Radar-Uniwa/5-6GHz-FMCW-Radar/Hardware/UFL footprint/CONMHF1-SMD-T.step

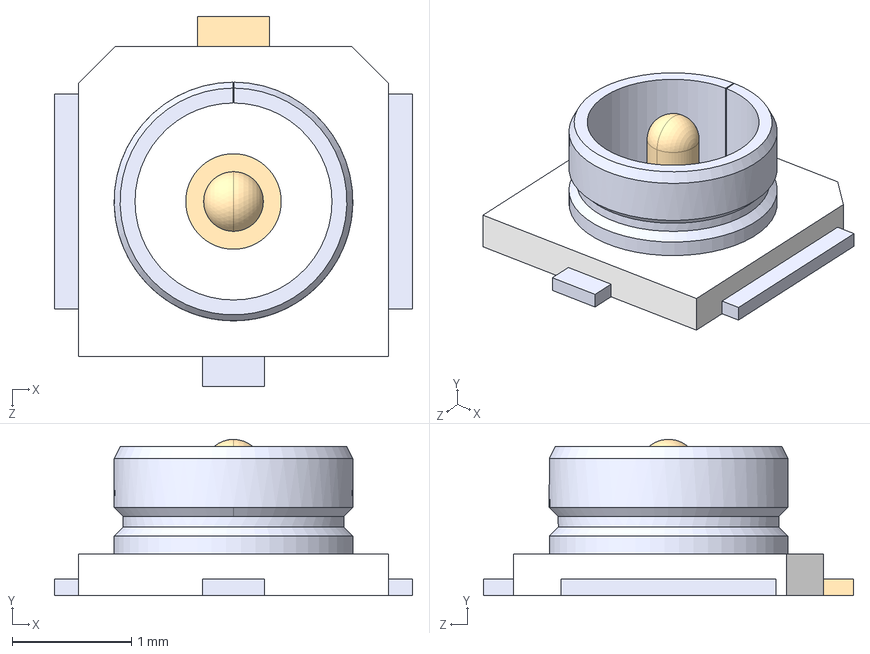
[picture p1: CAD file, 2026-07-16]
Hardware/UFL footprint/CONMHF1-SMD-T.step
3.00 x 1.31 x 3.10 mm
