Radar-Uniwa/5-6GHz-FMCW-Radar/(list of files, drawings)

Other design files:
CST/Coupler Simulation/Model/3D/Model.dsn
CST/Coupler Simulation/Model/DS/Model.dsn
