Radar-Uniwa/5-6GHz-FMCW-Radar/Hardware/adc.kicad_sch

## KiCad design Hardware/adc.kicad_sch (2026-07-16)

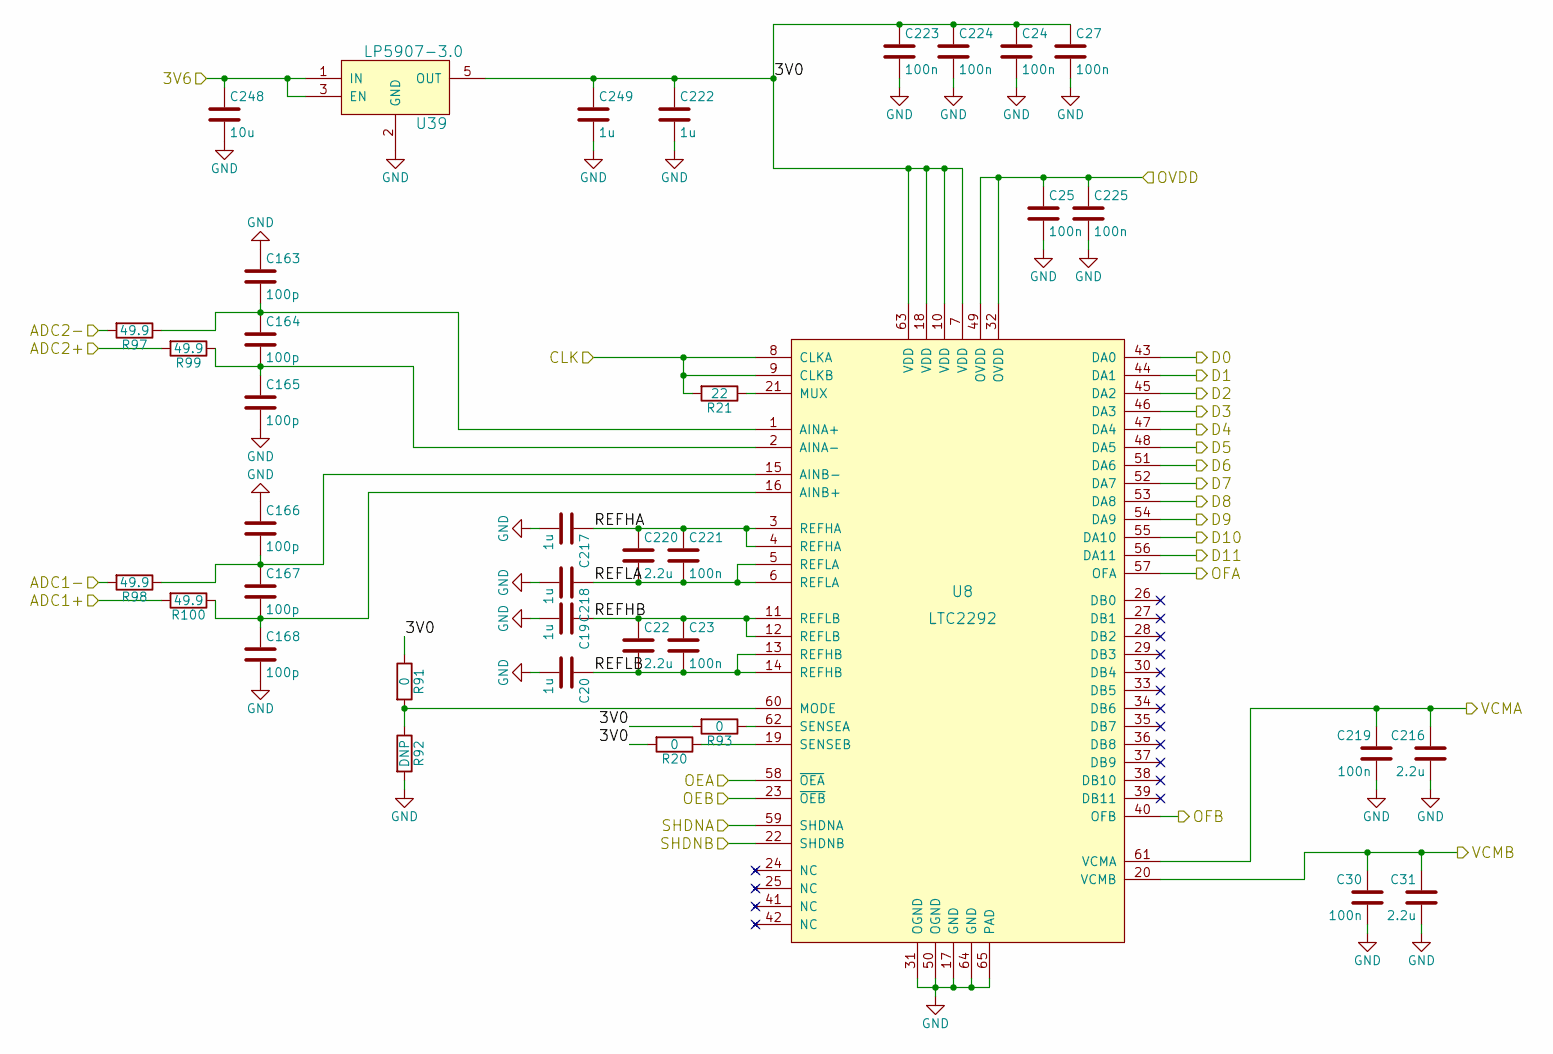
[picture p2: schematic adc.kicad_sch]

Parts:
C19, C20, C217, C218, C222, C249: 1u; C_0603b
C22, C31, C216, C220: 2.2u; C_0603b
C23, C24, C25, C27, C30, C219, C221, C223, C224, C225: 100n; C_0402b
C163, C164, C165, C166, C167, C168: 100p; C_0402b
C248: 10u; C_0805b
R20, R91, R93: 0; R_0402b
R21: 22; R_0402b
R92: DNP; R_0402b
R97, R98, R99, R100: 49.9; R_0402b
U8: LTC2292; QFN-64-1EP_9x9mm_Pitch0.5mm
U39: LP5907-3.0; SOT-23-5

Connections:
3V0: C24.1, C27.1, C222.1, C223.1, C224.1, C249.1, R20.2, R91.1, R93.2, U8.7 (VDD), U8.10 (VDD), U8.18 (VDD), U8.63 (VDD), U39.5 (OUT)
3V6: C248.1, U39.1 (IN), U39.3 (EN)
ADC1+: R100.2
ADC1-: R98.2
ADC2+: R99.2
ADC2-: R97.2
CLK: R21.2, U8.8 (CLKA), U8.9 (CLKB)
D0: U8.43 (DA0)
D1: U8.44 (DA1)
D2: U8.45 (DA2)
D3: U8.46 (DA3)
D4: U8.47 (DA4)
D5: U8.48 (DA5)
D6: U8.51 (DA6)
D7: U8.52 (DA7)
D8: U8.53 (DA8)
D9: U8.54 (DA9)
D10: U8.55 (DA10)
D11: U8.56 (DA11)
GND: C19.2, C20.2, C24.2, C25.2, C27.2, C30.2, C31.2, C163.1, C165.2, C166.1, C168.2, C216.2, C217.2, C218.2, C219.2, C222.2, C223.2, C224.2, C225.2, C248.2, C249.2, R92.2, U8.17 (GND), U8.31 (OGND), U8.50 (OGND), U8.64 (GND), U8.65 (PAD), U39.2 (GND)
unnamed: C163.2, C164.1, R97.1, U8.1 (AINA+)
unnamed: C164.2, C165.1, R99.1, U8.2 (AINA-)
unnamed: C166.2, C167.1, R98.1, U8.15 (AINB-)
unnamed: C167.2, C168.1, R100.1, U8.16 (AINB+)
unnamed: R20.1, U8.19 (SENSEB)
unnamed: R21.1, U8.21 (MUX)
unnamed: R91.2, R92.1, U8.60 (MODE)
unnamed: R93.1, U8.62 (SENSEA)
OEA: U8.58 (~OEA)
OEB: U8.23 (~OEB)
OFA: U8.57 (OFA)
OFB: U8.40 (OFB)
OVDD: C25.1, C225.1, U8.32 (OVDD), U8.49 (OVDD)
REFHA: C217.1, C220.1, C221.1, U8.3 (REFHA), U8.4 (REFHA)
REFHB: C19.1, C22.1, C23.1, U8.11 (REFLB), U8.12 (REFLB)
REFLA: C218.1, C220.2, C221.2, U8.5 (REFLA), U8.6 (REFLA)
REFLB: C20.1, C22.2, C23.2, U8.13 (REFHB), U8.14 (REFHB)
SHDNA: U8.59 (SHDNA)
SHDNB: U8.22 (SHDNB)
VCMA: C216.1, C219.1, U8.61 (VCMA)
VCMB: C30.1, C31.1, U8.20 (VCMB)
