Radar-Uniwa/5-6GHz-FMCW-Radar/Hardware/fmcw3.kicad_sch

## KiCad design Hardware/fmcw3.kicad_sch (2026-07-16)

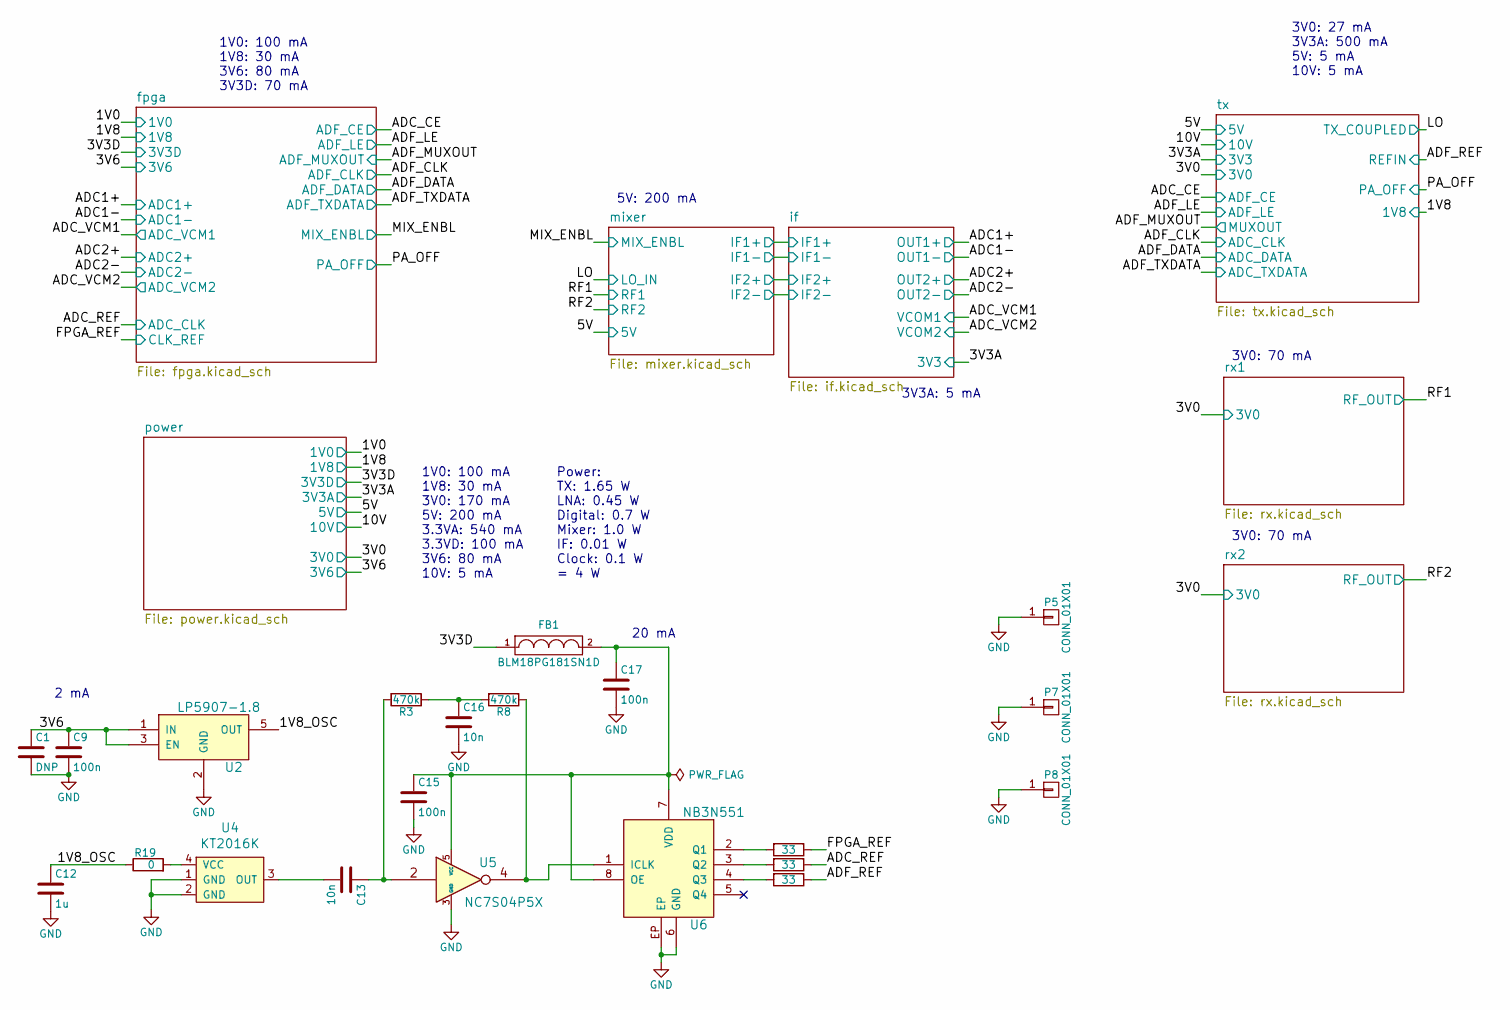
[picture p3: schematic fmcw3.kicad_sch]

Parts:
C1: DNP; C_0805b
C9, C15, C17: 100n; C_0402b
C12: 1u; C_0603b
C13, C16: 10n; C_0402b
FB1: BLM18PG181SN1D; C_0603b
P5, P7, P8: CONN_01X01; MountingHole_3.2mm_M3_Pad_Via_mod
R3, R8: 470k; R_0402b
R13, R15, R16: 33; R_0402b
R19: 0; R_0402b
U2: LP5907-1.8; SOT-23-5
U4: KT2016K
U5: NC7S04P5X; SOT-353_SC-70-5
U6: NB3N551; DFN-8

Connections:
1V8_OSC: C12.1, R19.1, U2.5 (OUT)
3V3D: FB1.1
3V6: C1.1, C9.1, U2.1 (IN), U2.3 (EN)
ADC_REF: R15.1
ADF_REF: R16.1
FPGA_REF: R13.1
GND: C1.2, C9.2, C12.2, C15.2, C16.2, C17.2, P5.1, P7.1, P8.1, U2.2 (GND), U4.1 (GND), U4.2 (GND), U5.3 (GND), U6.6 (GND), U6.EP
unnamed: C13.1, R3.2, U5.2
unnamed: C13.2, U4.3 (OUT)
unnamed: C15.1, C17.1, FB1.2, U5.5 (VCC), U6.7 (VDD), U6.8 (OE)
unnamed: C16.1, R3.1, R8.2
unnamed: R8.1, U5.4, U6.1 (ICLK)
unnamed: R13.2, U6.2 (Q1)
unnamed: R15.2, U6.3 (Q2)
unnamed: R16.2, U6.4 (Q3)
unnamed: R19.2, U4.4 (VCC)

Notes on the sheet:
5V: 200 mA
1V0: 100 mA 1V8: 30 mA 3V6: 80 mA 3V3D: 70 mA
3V0: 27 mA 3V3A: 500 mA 5V: 5 mA 10V: 5 mA
Power: TX: 1.65 W LNA: 0.45 W Digital: 0.7 W Mixer: 1.0 W IF: 0.01 W Clock: 0.1 W = 4 W
1V0: 100 mA 1V8: 30 mA 3V0: 170 mA 5V: 200 mA 3.3VA: 540 mA 3.3VD: 100 mA 3V6: 80 mA 10V: 5 mA
20 mA
2 mA
3V0: 70 mA
3V3A: 5 mA
