Radar-Uniwa/5-6GHz-FMCW-Radar/Hardware/fpga.kicad_sch

## KiCad design Hardware/fpga.kicad_sch (2026-07-16)

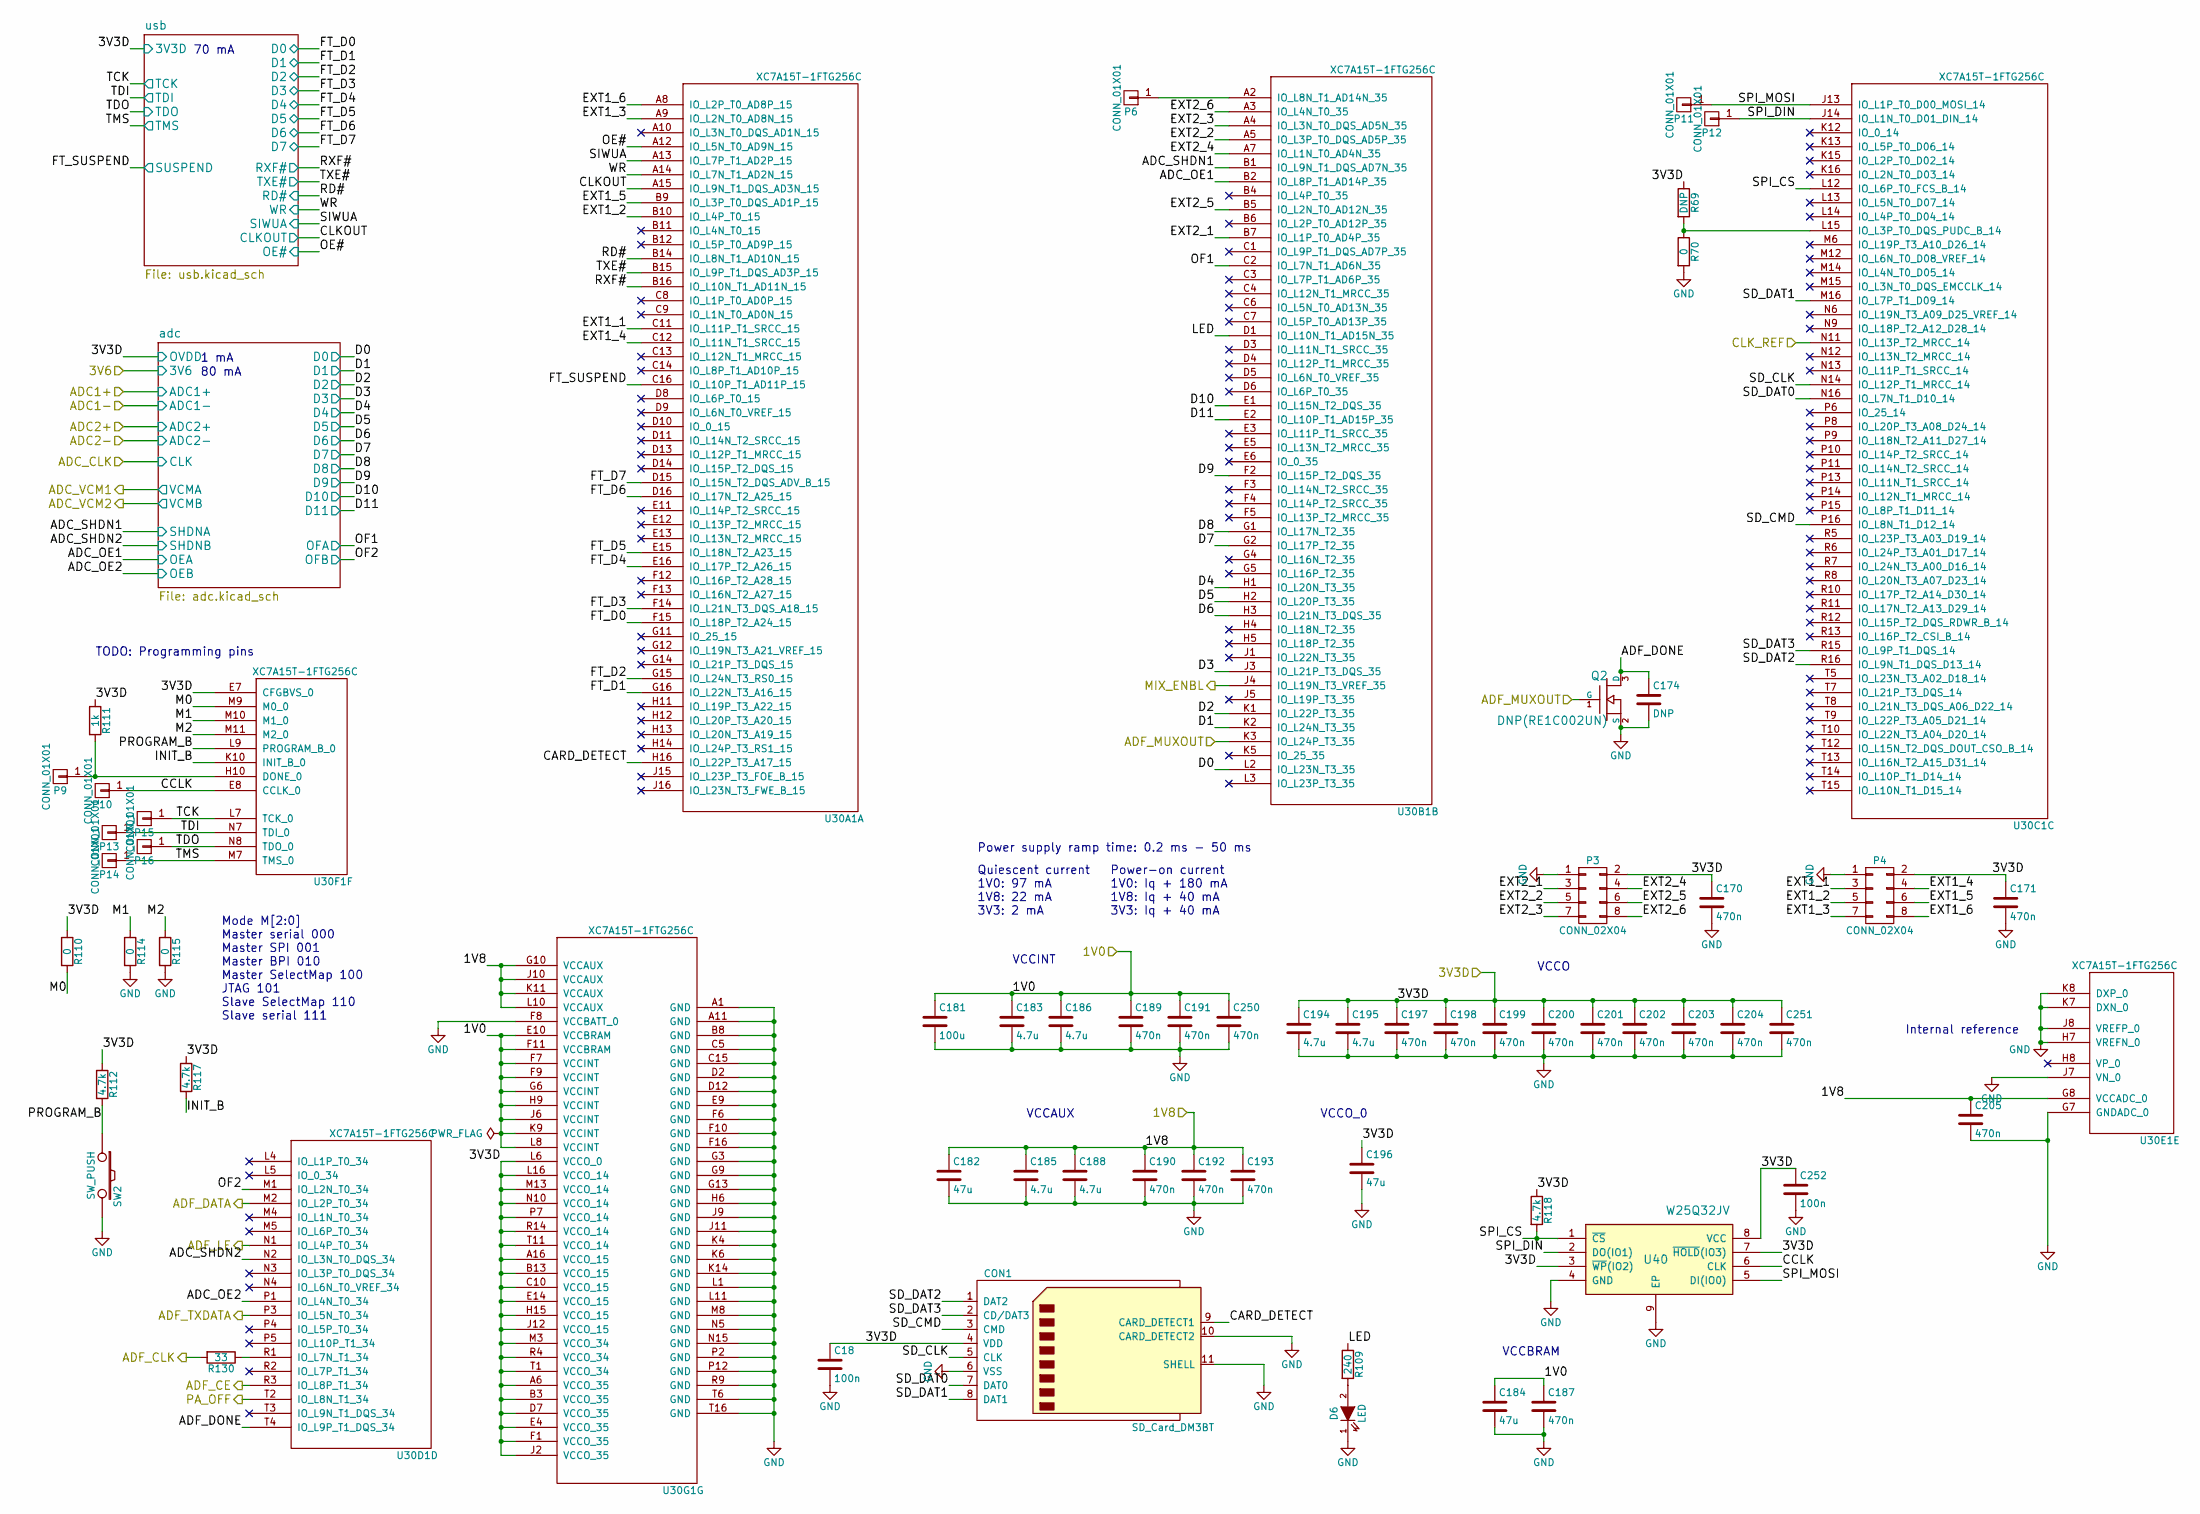
[picture p4: schematic fpga.kicad_sch]

Parts:
C18, C252: 100n; C_0402b
C170, C171, C187, C189, C190, C191, C192, C193, C197, C198, C199, C200, C201, C202, C203, C204, C205, C250, C251: 470n; C_0402b
C174: DNP; C_0402b
C181: 100u; C_1210
C182, C184, C196: 47u; C_1206
C183, C185, C186, C188, C194, C195: 4.7u; C_0805b
CON1: SD_Card_DM3BT; DM3BT-DSF-PEJS
D6: LED; LED_0603
P3, P4: CONN_02X04; Pin_Header_Straight_2x04_Pitch2.54mm_SMD
P6, P9, P10, P11, P12, P13, P14, P15, P16: CONN_01X01; TP_1.00
Q2: DNP(RE1C002UN); SOT-416
R69: DNP; R_0402b
R70, R110, R114, R115: 0; R_0402b
R109: 240; R_0402b
R111: 1k; R_0402b
R112, R117, R118: 4.7k; R_0402b
R130: 33; R_0402b
SW2: SW_PUSH; EVP-AWBA2A
U30A1, U30B1, U30C1, U30D1, U30E1, U30F1, U30G1: XC7A15T-1FTG256C; FTG256
U40: W25Q32JV; DFN-S-8-1EP_6x5mm_Pitch1.27mm

Connections:
1V0: C181.1, C183.1, C184.1, C186.1, C187.1, C189.1, C191.1, C250.1, U30G1.E10 (VCCBRAM), U30G1.F7 (VCCINT), U30G1.F9 (VCCINT), U30G1.F11 (VCCBRAM), U30G1.G6 (VCCINT), U30G1.H9 (VCCINT), U30G1.J6 (VCCINT), U30G1.K9 (VCCINT), U30G1.L8 (VCCINT)
1V8: C182.1, C185.1, C188.1, C190.1, C192.1, C193.1, C205.1, U30E1.G8 (VCCADC_0), U30G1.G10 (VCCAUX), U30G1.J10 (VCCAUX), U30G1.K11 (VCCAUX), U30G1.L10 (VCCAUX)
3V3D: C18.1, C170.1, C171.1, C194.1, C195.1, C196.1, C197.1, C198.1, C199.1, C200.1, C201.1, C202.1, C203.1, C204.1, C251.1, C252.1, CON1.4 (VDD), P3.2, P4.2, R69.1, R110.1, R111.1, R112.1, R117.1, R118.1, U30F1.E7 (CFGBVS_0), U30G1.A6 (VCCO_35), U30G1.A16 (VCCO_15), U30G1.B3 (VCCO_35), U30G1.B13 (VCCO_15), U30G1.C10 (VCCO_15), U30G1.D7 (VCCO_35), U30G1.E4 (VCCO_35), U30G1.E14 (VCCO_15), U30G1.F1 (VCCO_35), U30G1.H15 (VCCO_15), U30G1.J2 (VCCO_35), U30G1.J12 (VCCO_15), U30G1.L6 (VCCO_0), U30G1.L16 (VCCO_14), U30G1.M3 (VCCO_34), U30G1.M13 (VCCO_14), U30G1.N10 (VCCO_14), U30G1.P7 (VCCO_14), U30G1.R4 (VCCO_34), U30G1.R14 (VCCO_14), U30G1.T1 (VCCO_34), U30G1.T11 (VCCO_14), U40.3 (~WP(IO2)), U40.7 (~HOLD(IO3)), U40.8 (VCC)
ADC_OE1: U30B1.B2 (IO_L8P_T1_AD14P_35)
ADC_OE2: U30D1.P1 (IO_L4N_T0_34)
ADC_SHDN1: U30B1.B1 (IO_L9N_T1_DQS_AD7N_35)
ADC_SHDN2: U30D1.N2 (IO_L3N_T0_DQS_34)
ADF_CE: U30D1.R3 (IO_L8P_T1_34)
ADF_CLK: R130.2
ADF_DATA: U30D1.M2 (IO_L2P_T0_34)
ADF_DONE: C174.1, Q2.3 (D), U30D1.T4 (IO_L9P_T1_DQS_34)
ADF_LE: U30D1.N1 (IO_L4P_T0_34)
ADF_MUXOUT: Q2.1 (G), U30B1.K3 (IO_L24P_T3_35)
ADF_TXDATA: U30D1.P3 (IO_L5N_T0_34)
CARD_DETECT: CON1.9 (CARD_DETECT1), U30A1.H16 (IO_L22P_T3_A17_15)
CCLK: P10.1, U30F1.E8 (CCLK_0), U40.6 (CLK)
CLKOUT: U30A1.A15 (IO_L9N_T1_DQS_AD3N_15)
CLK_REF: U30C1.N11 (IO_L13P_T2_MRCC_14)
D0: U30B1.L2 (IO_L23N_T3_35)
D1: U30B1.K2 (IO_L24N_T3_35)
D2: U30B1.K1 (IO_L22P_T3_35)
D3: U30B1.J3 (IO_L21P_T3_DQS_35)
D4: U30B1.H1 (IO_L20N_T3_35)
D5: U30B1.H2 (IO_L20P_T3_35)
D6: U30B1.H3 (IO_L21N_T3_DQS_35)
D7: U30B1.G2 (IO_L17P_T2_35)
D8: U30B1.G1 (IO_L17N_T2_35)
D9: U30B1.F2 (IO_L15P_T2_DQS_35)
D10: U30B1.E1 (IO_L15N_T2_DQS_35)
D11: U30B1.E2 (IO_L10P_T1_AD15P_35)
EXT1_1: P4.3, U30A1.C11 (IO_L11P_T1_SRCC_15)
EXT1_2: P4.5, U30A1.B10 (IO_L4P_T0_15)
EXT1_3: P4.7, U30A1.A9 (IO_L2N_T0_AD8N_15)
EXT1_4: P4.4, U30A1.C12 (IO_L11N_T1_SRCC_15)
EXT1_5: P4.6, U30A1.B9 (IO_L3P_T0_DQS_AD1P_15)
EXT1_6: P4.8, U30A1.A8 (IO_L2P_T0_AD8P_15)
EXT2_1: P3.3, U30B1.B7 (IO_L1P_T0_AD4P_35)
EXT2_2: P3.5, U30B1.A5 (IO_L3P_T0_DQS_AD5P_35)
EXT2_3: P3.7, U30B1.A4 (IO_L3N_T0_DQS_AD5N_35)
EXT2_4: P3.4, U30B1.A7 (IO_L1N_T0_AD4N_35)
EXT2_5: P3.6, U30B1.B5 (IO_L2N_T0_AD12N_35)
EXT2_6: P3.8, U30B1.A3 (IO_L4N_T0_35)
FT_D0: U30A1.F15 (IO_L18P_T2_A24_15)
FT_D1: U30A1.G16 (IO_L22N_T3_A16_15)
FT_D2: U30A1.G15 (IO_L24N_T3_RS0_15)
FT_D3: U30A1.F14 (IO_L21N_T3_DQS_A18_15)
FT_D4: U30A1.E16 (IO_L17P_T2_A26_15)
FT_D5: U30A1.E15 (IO_L18N_T2_A23_15)
FT_D6: U30A1.D16 (IO_L17N_T2_A25_15)
FT_D7: U30A1.D15 (IO_L15N_T2_DQS_ADV_B_15)
FT_SUSPEND: U30A1.C16 (IO_L10P_T1_AD11P_15)
GND: C18.2, C170.2, C171.2, C174.2, C181.2, C182.2, C183.2, C184.2, C185.2, C186.2, C187.2, C188.2, C189.2, C190.2, C191.2, C192.2, C193.2, C194.2, C195.2, C196.2, C197.2, C198.2, C199.2, C200.2, C201.2, C202.2, C203.2, C204.2, C205.2, C250.2, C251.2, C252.2, CON1.6 (VSS), CON1.10 (CARD_DETECT2), CON1.11 (SHELL), D6.1 (K), P3.1, P4.1, Q2.2 (S), R70.2, R114.2, R115.2, SW2.2, U30E1.G7 (GNDADC_0), U30E1.H7 (VREFN_0), U30E1.J7 (VN_0), U30E1.J8 (VREFP_0), U30E1.K7 (DXN_0), U30E1.K8 (DXP_0), U30G1.A1 (GND), U30G1.A11 (GND), U30G1.B8 (GND), U30G1.C5 (GND), U30G1.C15 (GND), U30G1.D2 (GND), U30G1.D12 (GND), U30G1.E9 (GND), U30G1.F6 (GND), U30G1.F8 (VCCBATT_0), U30G1.F10 (GND), U30G1.F16 (GND), U30G1.G3 (GND), U30G1.G9 (GND), U30G1.G13 (GND), U30G1.H6 (GND), U30G1.J9 (GND), U30G1.J11 (GND), U30G1.K4 (GND), U30G1.K6 (GND), U30G1.K14 (GND), U30G1.L1 (GND), U30G1.L11 (GND), U30G1.M8 (GND), U30G1.N5 (GND), U30G1.N15 (GND), U30G1.P2 (GND), U30G1.P12 (GND), U30G1.R9 (GND), U30G1.T6 (GND), U30G1.T16 (GND), U40.4 (GND), U40.9 (EP)
INIT_B: R117.2, U30F1.K10 (INIT_B_0)
LED: R109.1, U30B1.D1 (IO_L10N_T1_AD15N_35)
M0: R110.2, U30F1.M9 (M0_0)
M1: R114.1, U30F1.M10 (M1_0)
M2: R115.1, U30F1.M11 (M2_0)
MIX_ENBL: U30B1.J4 (IO_L19N_T3_VREF_35)
unnamed: D6.2 (A), R109.2
unnamed: P6.1, U30B1.A2 (IO_L8N_T1_AD14N_35)
unnamed: P9.1, R111.2, U30F1.H10 (DONE_0)
unnamed: R69.2, R70.1, U30C1.L15 (IO_L3P_T0_DQS_PUDC_B_14)
unnamed: R130.1, U30D1.R1 (IO_L7N_T1_34)
OE#: U30A1.A12 (IO_L5N_T0_AD9N_15)
OF1: U30B1.C2 (IO_L7N_T1_AD6N_35)
OF2: U30D1.M1 (IO_L2N_T0_34)
PA_OFF: U30D1.T2 (IO_L8N_T1_34)
PROGRAM_B: R112.2, SW2.1, U30F1.L9 (PROGRAM_B_0)
RD#: U30A1.B14 (IO_L8N_T1_AD10N_15)
RXF#: U30A1.B16 (IO_L10N_T1_AD11N_15)
SD_CLK: CON1.5 (CLK), U30C1.N14 (IO_L12P_T1_MRCC_14)
SD_CMD: CON1.3 (CMD), U30C1.P16 (IO_L8N_T1_D12_14)
SD_DAT0: CON1.7 (DAT0), U30C1.N16 (IO_L7N_T1_D10_14)
SD_DAT1: CON1.8 (DAT1), U30C1.M16 (IO_L7P_T1_D09_14)
SD_DAT2: CON1.1 (DAT2), U30C1.R16 (IO_L9N_T1_DQS_D13_14)
SD_DAT3: CON1.2 (CD/DAT3), U30C1.R15 (IO_L9P_T1_DQS_14)
SIWUA: U30A1.A13 (IO_L7P_T1_AD2P_15)
SPI_CS: R118.2, U30C1.L12 (IO_L6P_T0_FCS_B_14), U40.1 (~CS)
SPI_DIN: P12.1, U30C1.J14 (IO_L1N_T0_D01_DIN_14), U40.2 (DO(IO1))
SPI_MOSI: P11.1, U30C1.J13 (IO_L1P_T0_D00_MOSI_14), U40.5 (DI(IO0))
TCK: P15.1, U30F1.L7 (TCK_0)
TDI: P13.1, U30F1.N7 (TDI_0)
TDO: P16.1, U30F1.N8 (TDO_0)
TMS: P14.1, U30F1.M7 (TMS_0)
TXE#: U30A1.B15 (IO_L9P_T1_DQS_AD3P_15)
WR: U30A1.A14 (IO_L7N_T1_AD2N_15)

Notes on the sheet:
80 mA
1 mA
Quiescent current 1V0: 97 mA 1V8: 22 mA 3V3: 2 mA
Power-on current 1V0: Iq + 180 mA 1V8: Iq + 40 mA 3V3: Iq + 40 mA
70 mA
Internal reference
VCCAUX
Power supply ramp time: 0.2 ms - 50 ms
TODO: Programming pins
VCCINT
VCCBRAM
Mode M[2:0] Master serial 000 Master SPI 001 Master BPI 010 Master SelectMap 100 JTAG 101 Slave SelectMap 110 Slave serial 111
VCCO
VCCO_0
