Radar-Uniwa/5-6GHz-FMCW-Radar/Hardware/if.kicad_sch

## KiCad design Hardware/if.kicad_sch (2026-07-16)

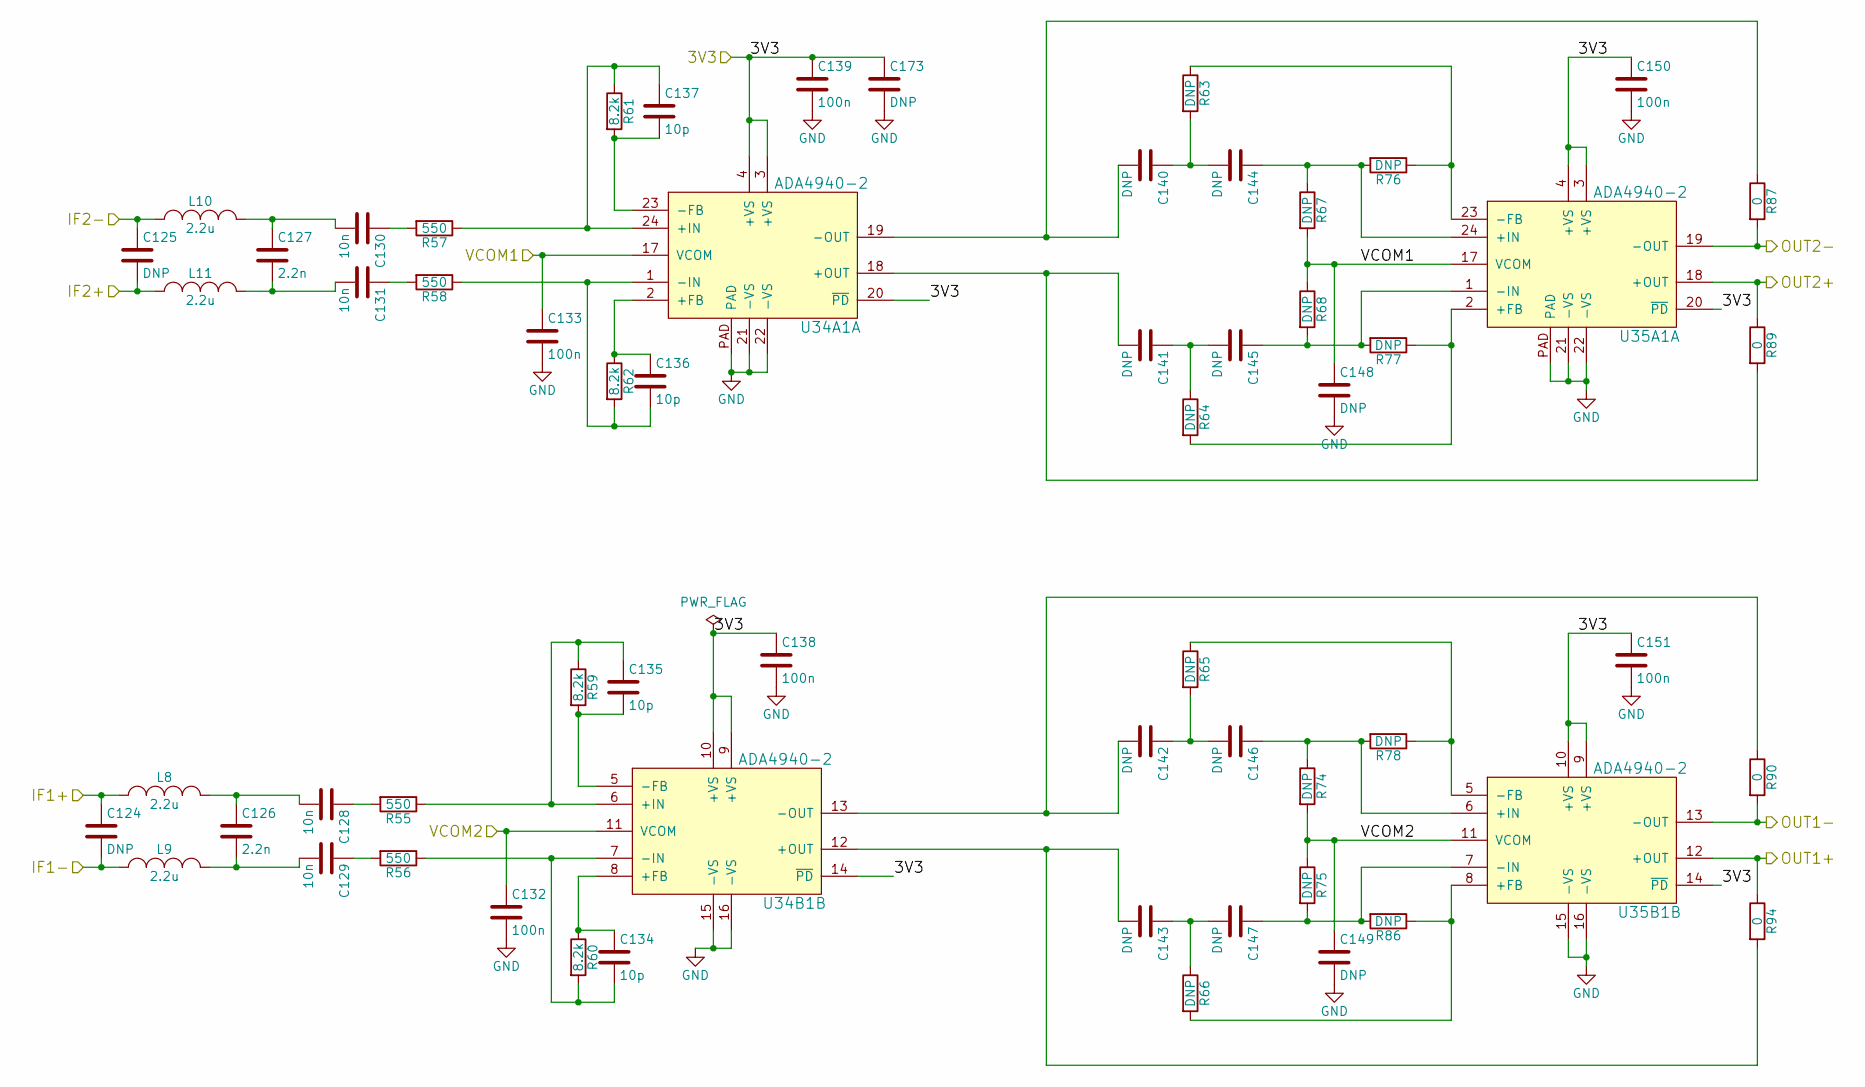
[picture p5: schematic if.kicad_sch]

Parts:
C124, C125, C140, C141, C142, C143, C144, C145, C146, C147, C148, C149: DNP; C_0402b
C126, C127: 2.2n; C_0402b
C128, C129, C130, C131: 10n; C_0402b
C132, C133, C138, C139, C150, C151: 100n; C_0402b
C134, C135, C136, C137: 10p; C_0402b
C173: DNP; C_0805b
L8, L9, L10, L11: 2.2u; C_0805b
R55, R56, R57, R58: 550; R_0402b
R59, R60, R61, R62: 8.2k; R_0402b
R63, R64, R65, R66, R67, R68, R74, R75, R76, R77, R78, R86: DNP; R_0402b
R87, R89, R90, R94: 0; R_0402b
U34A1, U34B1, U35A1, U35B1: ADA4940-2; VFQFN-24

Connections:
3V3: C138.1, C139.1, C150.1, C151.1, C173.1, U34A1.3 (+VS), U34A1.4 (+VS), U34A1.20 (~PD), U34B1.9 (+VS), U34B1.10 (+VS), U34B1.14 (~PD), U35A1.3 (+VS), U35A1.4 (+VS), U35A1.20 (~PD), U35B1.9 (+VS), U35B1.10 (+VS), U35B1.14 (~PD)
GND: C132.2, C133.2, C138.2, C139.2, C148.2, C149.2, C150.2, C151.2, C173.2, U34A1.21 (-VS), U34A1.22 (-VS), U34A1.PAD, U34B1.15 (-VS), U34B1.16 (-VS), U35A1.21 (-VS), U35A1.22 (-VS), U35A1.PAD, U35B1.15 (-VS), U35B1.16 (-VS)
IF1+: C124.1, L8.1
IF1-: C124.2, L9.1
IF2+: C125.2, L11.1
IF2-: C125.1, L10.1
unnamed: C126.1, C128.2, L8.2
unnamed: C126.2, C129.2, L9.2
unnamed: C127.1, C130.2, L10.2
unnamed: C127.2, C131.2, L11.2
unnamed: C128.1, R55.2
unnamed: C129.1, R56.2
unnamed: C130.1, R57.2
unnamed: C131.1, R58.2
unnamed: C134.1, R60.1, U34B1.8 (+FB)
unnamed: C134.2, R56.1, R60.2, U34B1.7 (-IN)
unnamed: C135.1, R55.1, R59.1, U34B1.6 (+IN)
unnamed: C135.2, R59.2, U34B1.5 (-FB)
unnamed: C136.1, R62.1, U34A1.2 (+FB)
unnamed: C136.2, R58.1, R62.2, U34A1.1 (-IN)
unnamed: C137.1, R57.1, R61.1, U34A1.24 (+IN)
unnamed: C137.2, R61.2, U34A1.23 (-FB)
unnamed: C140.1, C144.2, R63.2
unnamed: C140.2, R87.1, U34A1.19 (-OUT)
unnamed: C141.1, C145.2, R64.1
unnamed: C141.2, R89.2, U34A1.18 (+OUT)
unnamed: C142.1, C146.2, R65.2
unnamed: C142.2, R90.1, U34B1.13 (-OUT)
unnamed: C143.1, C147.2, R66.1
unnamed: C143.2, R94.2, U34B1.12 (+OUT)
unnamed: C144.1, R67.1, R76.2, U35A1.24 (+IN)
unnamed: C145.1, R68.2, R77.2, U35A1.1 (-IN)
unnamed: C146.1, R74.1, R78.2, U35B1.6 (+IN)
unnamed: C147.1, R75.2, R86.2, U35B1.7 (-IN)
unnamed: R63.1, R76.1, U35A1.23 (-FB)
unnamed: R64.2, R77.1, U35A1.2 (+FB)
unnamed: R65.1, R78.1, U35B1.5 (-FB)
unnamed: R66.2, R86.1, U35B1.8 (+FB)
OUT1+: R94.1, U35B1.12 (+OUT)
OUT1-: R90.2, U35B1.13 (-OUT)
OUT2+: R89.1, U35A1.18 (+OUT)
OUT2-: R87.2, U35A1.19 (-OUT)
VCOM1: C133.1, C148.1, R67.2, R68.1, U34A1.17 (VCOM), U35A1.17 (VCOM)
VCOM2: C132.1, C149.1, R74.2, R75.1, U34B1.11 (VCOM), U35B1.11 (VCOM)
