Radar-Uniwa/5-6GHz-FMCW-Radar/Hardware/mixer.kicad_sch

## KiCad design Hardware/mixer.kicad_sch (2026-07-16)

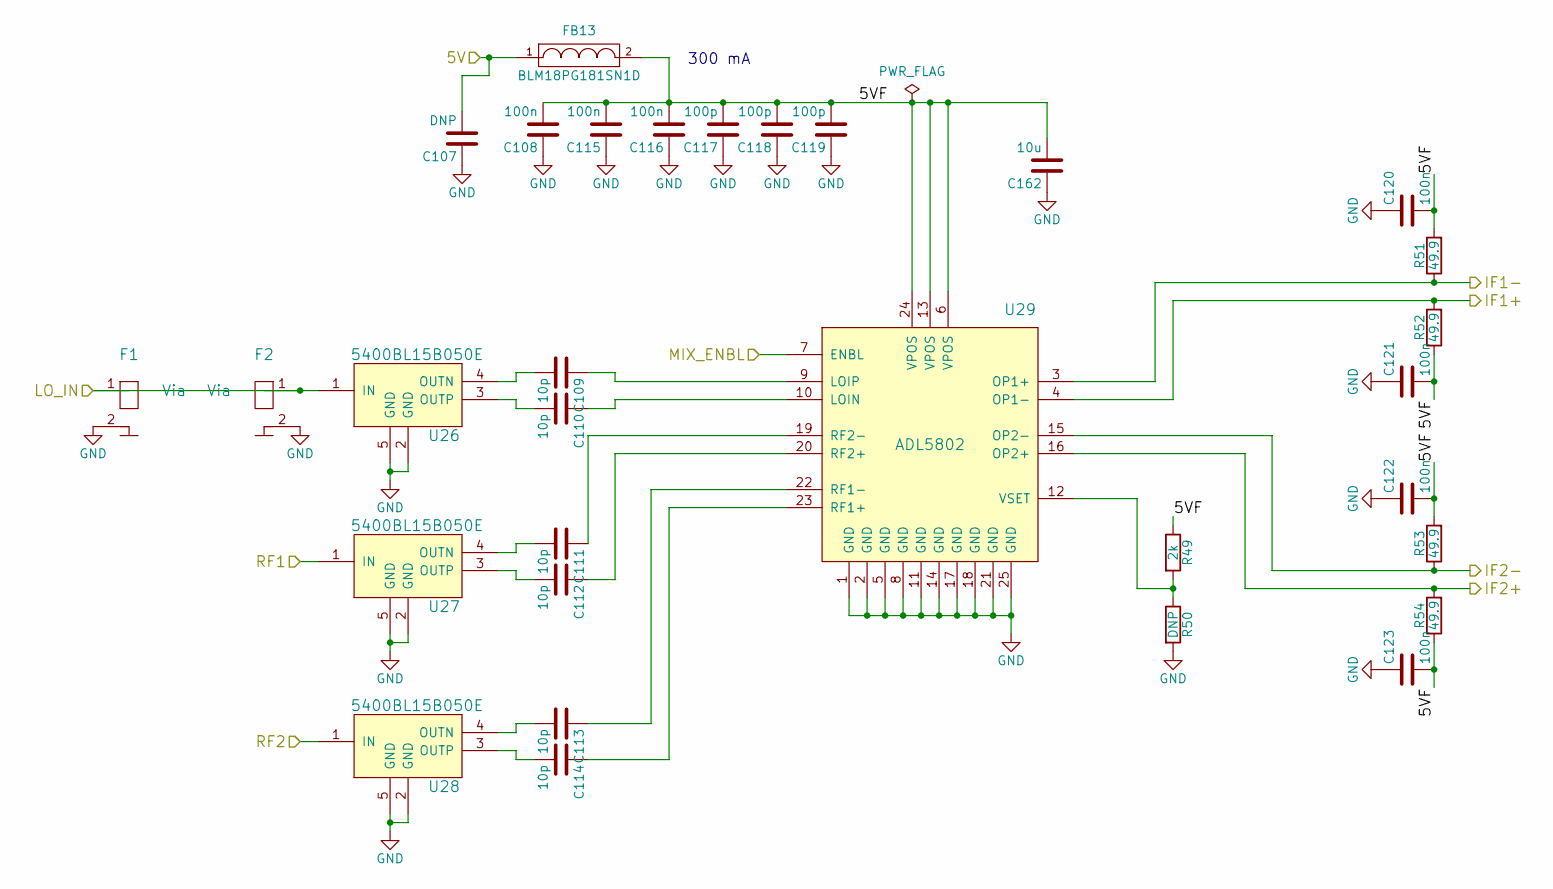
[picture p6: schematic mixer.kicad_sch]

Parts:
C107: DNP; C_0805b
C108, C115, C116, C120, C121, C122, C123: 100n; C_0402b
C109, C110, C111, C112, C113, C114: 10p; C_0402b
C117, C118, C119: 100p; C_0402b
C162: 10u; C_0805b
F1, F2: Via; RF_via
FB13: BLM18PG181SN1D; C_0603b
R49: 2k; R_0402b
R50: DNP; R_0402b
R51, R52, R53, R54: 49.9; R_0402b
U26, U27, U28: 5400BL15B050E
U29: ADL5802; QFN-24-1EP_4x4mm_Pitch0.5mm

Connections:
5V: C107.2, FB13.1
5VF: C108.2, C115.2, C116.2, C117.2, C118.2, C119.2, C120.2, C121.2, C122.2, C123.2, C162.2, FB13.2, R49.1, R51.2, R52.1, R53.2, R54.1, U29.6 (VPOS), U29.13 (VPOS), U29.24 (VPOS)
GND: C107.1, C108.1, C115.1, C116.1, C117.1, C118.1, C119.1, C120.1, C121.1, C122.1, C123.1, C162.1, F1.2, F2.2, R50.2, U26.2 (GND), U26.5 (GND), U27.2 (GND), U27.5 (GND), U28.2 (GND), U28.5 (GND), U29.1 (GND), U29.2 (GND), U29.5 (GND), U29.8 (GND), U29.11 (GND), U29.14 (GND), U29.17 (GND), U29.18 (GND), U29.21 (GND), U29.25 (GND)
IF1+: R52.2, U29.4 (OP1-)
IF1-: R51.1, U29.3 (OP1+)
IF2+: R54.2, U29.16 (OP2+)
IF2-: R53.1, U29.15 (OP2-)
LO_IN: F1.1, F2.1, U26.1 (IN)
MIX_ENBL: U29.7 (ENBL)
unnamed: C109.1, U29.9 (LOIP)
unnamed: C109.2, U26.4 (OUTN)
unnamed: C110.1, U29.10 (LOIN)
unnamed: C110.2, U26.3 (OUTP)
unnamed: C111.1, U29.19 (RF2-)
unnamed: C111.2, U27.4 (OUTN)
unnamed: C112.1, U29.20 (RF2+)
unnamed: C112.2, U27.3 (OUTP)
unnamed: C113.1, U29.22 (RF1-)
unnamed: C113.2, U28.4 (OUTN)
unnamed: C114.1, U29.23 (RF1+)
unnamed: C114.2, U28.3 (OUTP)
unnamed: R49.2, R50.1, U29.12 (VSET)
RF1: U27.1 (IN)
RF2: U28.1 (IN)

Notes on the sheet:
300 mA
