Radar-Uniwa/5-6GHz-FMCW-Radar/Hardware/power.kicad_sch

## KiCad design Hardware/power.kicad_sch (2026-07-16)

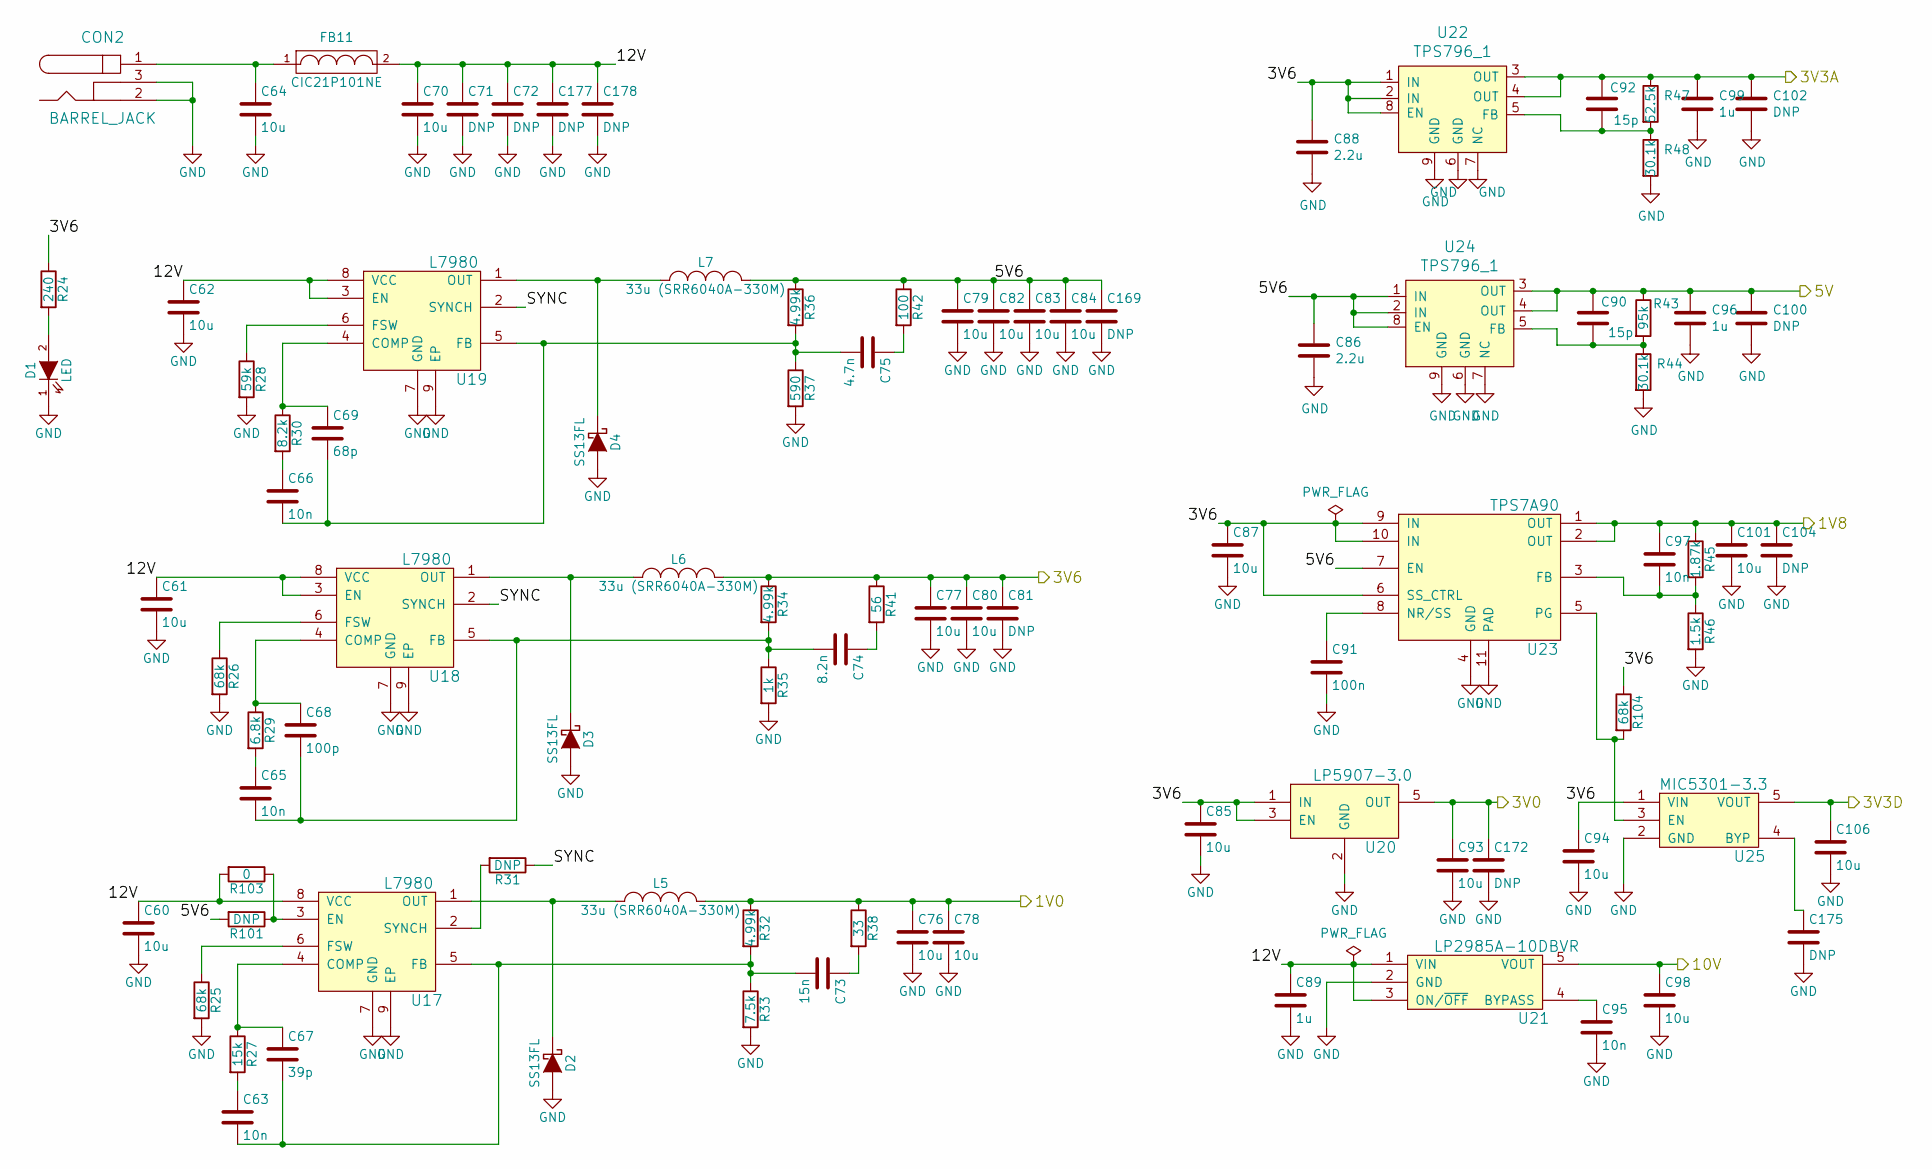
[picture p7: schematic power.kicad_sch]

Parts:
C60, C61, C62, C64, C70, C76, C77, C78, C79, C80, C82, C83, C84, C85, C87, C93, C94, C98, C101, C106: 10u; C_0805b
C63, C65, C66, C95, C97: 10n; C_0402b
C67: 39p; C_0402b
C68: 100p; C_0402b
C69: 68p; C_0402b
C71, C72, C81, C104, C169, C172, C177, C178: DNP; C_0805b
C73: 15n; C_0402b
C74: 8.2n; C_0402b
C75: 4.7n; C_0402b
C86, C88: 2.2u; C_0402b
C89: 1u; C_0603b
C90, C92: 15p; C_0402b
C91: 100n; C_0402b
C96, C99: 1u; C_0402b
C100, C102, C175: DNP; C_0402b
CON2: BARREL_JACK; EJ508A
D1: LED; LED_0603
D2, D3, D4: SS13FL; SOD-123F
FB11: CIC21P101NE; C_0805b
L5, L6, L7: 33u (SRR6040A-330M); SRR6040A
R24: 240; R_0402b
R25, R26, R104: 68k; R_0402b
R27: 15k; R_0402b
R28: 59k; R_0402b
R29: 6.8k; R_0402b
R30: 8.2k; R_0402b
R31, R101: DNP; R_0402b
R32, R34, R36: 4.99k; R_0402b
R33: 7.5k; R_0402b
R35: 1k; R_0402b
R37: 590; R_0402b
R38: 33; R_0402b
R41: 56; R_0402b
R42: 100; R_0402b
R43: 95k; R_0402b
R44, R48: 30.1k; R_0402b
R45: 1.87k; R_0402b
R46: 1.5k; R_0402b
R47: 52.5k; R_0402b
R103: 0; R_0402b
U17, U18, U19: L7980; DFN-8-1EP_3x3mm_Pitch0.5mm
U20: LP5907-3.0; SOT-23-5
U21: LP2985A-10DBVR; SOT-23-5
U22, U24: TPS796_1
U23: TPS7A90; SON-10_2.5x2.5mm
U25: MIC5301-3.3; SOT-23-5

Connections:
1V0: C76.1, C78.1, L5.2, R32.1, R38.1
1V8: C97.1, C101.1, C104.1, R45.1, U23.1 (OUT), U23.2 (OUT)
3V0: C93.1, C172.1, U20.5 (OUT)
3V3A: C92.1, C99.1, C102.1, R47.1, U22.3 (OUT), U22.4 (OUT)
3V3D: C106.1, U25.5 (VOUT)
3V6: C77.1, C80.1, C81.1, C85.1, C87.1, C88.1, C94.1, L6.2, R24.1, R34.1, R41.1, R104.1, U20.1 (IN), U20.3 (EN), U22.1 (IN), U22.2 (IN), U22.8 (EN), U23.6 (SS_CTRL), U23.9 (IN), U23.10 (IN), U25.1 (VIN)
5V: C90.1, C96.1, C100.1, R43.1, U24.3 (OUT), U24.4 (OUT)
5V6: C79.1, C82.1, C83.1, C84.1, C86.1, C169.1, L7.2, R36.1, R42.1, R101.2, U23.7 (EN), U24.1 (IN), U24.2 (IN), U24.8 (EN)
10V: C98.1, U21.5 (VOUT)
12V: C60.1, C61.1, C62.1, C70.1, C71.1, C72.1, C89.1, C177.1, C178.1, FB11.2, R103.2, U17.8 (VCC), U18.3 (EN), U18.8 (VCC), U19.3 (EN), U19.8 (VCC), U21.1 (VIN), U21.3 (ON/~OFF)
GND: C60.2, C61.2, C62.2, C64.2, C70.2, C71.2, C72.2, C76.2, C77.2, C78.2, C79.2, C80.2, C81.2, C82.2, C83.2, C84.2, C85.2, C86.2, C87.2, C88.2, C89.2, C91.2, C93.2, C94.2, C95.2, C96.2, C98.2, C99.2, C100.2, C101.2, C102.2, C104.2, C106.2, C169.2, C172.2, C175.2, C177.2, C178.2, CON2.2, CON2.3, D1.1 (K), D2.2 (A), D3.2 (A), D4.2 (A), R25.2, R26.2, R28.2, R33.2, R35.2, R37.2, R44.2, R46.2, R48.2, U17.7 (GND), U17.9 (EP), U18.7 (GND), U18.9 (EP), U19.7 (GND), U19.9 (EP), U20.2 (GND), U21.2 (GND), U22.6 (GND), U22.7 (NC), U22.9 (GND), U23.4 (GND), U23.11 (PAD), U24.6 (GND), U24.7 (NC), U24.9 (GND), U25.2 (GND)
unnamed: C63.1, R27.2
unnamed: C63.2, C67.2, C73.2, R32.2, R33.1, U17.5 (FB)
unnamed: C64.1, CON2.1, FB11.1
unnamed: C65.1, R29.2
unnamed: C65.2, C68.2, C74.2, R34.2, R35.1, U18.5 (FB)
unnamed: C66.1, R30.2
unnamed: C66.2, C69.2, C75.2, R36.2, R37.1, U19.5 (FB)
unnamed: C67.1, R27.1, U17.4 (COMP)
unnamed: C68.1, R29.1, U18.4 (COMP)
unnamed: C69.1, R30.1, U19.4 (COMP)
unnamed: C73.1, R38.2
unnamed: C74.1, R41.2
unnamed: C75.1, R42.2
unnamed: C90.2, R43.2, R44.1, U24.5 (FB)
unnamed: C91.1, U23.8 (NR/SS)
unnamed: C92.2, R47.2, R48.1, U22.5 (FB)
unnamed: C95.1, U21.4 (BYPASS)
unnamed: C97.2, R45.2, R46.1, U23.3 (FB)
unnamed: C175.1, U25.4 (BYP)
unnamed: D1.2 (A), R24.2
unnamed: D2.1 (K), L5.1, U17.1 (OUT)
unnamed: D3.1 (K), L6.1, U18.1 (OUT)
unnamed: D4.1 (K), L7.1, U19.1 (OUT)
unnamed: R25.1, U17.6 (FSW)
unnamed: R26.1, U18.6 (FSW)
unnamed: R28.1, U19.6 (FSW)
unnamed: R31.2, U17.2 (SYNCH)
unnamed: R101.1, R103.1, U17.3 (EN)
unnamed: R104.2, U23.5 (PG), U25.3 (EN)
SYNC: R31.1, U18.2 (SYNCH), U19.2 (SYNCH)
