Radar-Uniwa/5-6GHz-FMCW-Radar/Hardware/rx.kicad_sch

## KiCad design Hardware/rx.kicad_sch (2026-07-16)

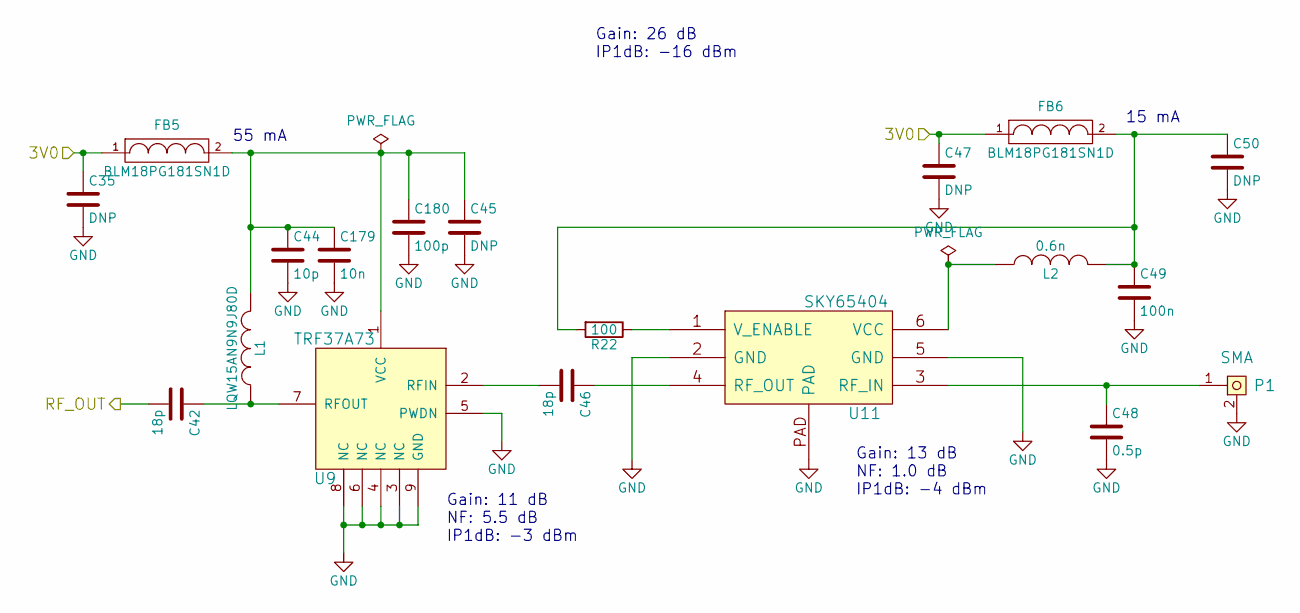
[picture p8: schematic rx.kicad_sch]

Parts:
C35, C45, C47, C50: DNP; C_0603b
C42, C46: 18p; C_0402b
C44: 10p; C_0402b
C48: 0.5p; C_0402b
C49: 100n; C_0402b
C179: 10n; C_0402b
C180: 100p; C_0402b
FB5, FB6: BLM18PG181SN1D; C_0603b
L1: LQW15AN9N9J80D; C_0402b
L2: 0.6n; C_0402b
P1: SMA; CONSMA003.062
R22: 100; R_0402b
U9: TRF37A73; DFN-8-1EP_2x2mm_Pitch0.5mm
U11: SKY65404; XFDFN-6

Connections:
3V0: C35.1, C47.1, FB5.1, FB6.1
GND: C35.2, C44.2, C45.2, C47.2, C48.2, C49.2, C50.2, C179.2, C180.2, P1.2, U9.3 (NC), U9.4 (NC), U9.5 (PWDN), U9.6 (NC), U9.8 (NC), U9.9 (GND), U11.2 (GND), U11.5 (GND), U11.PAD
unnamed: C42.1, L1.1, U9.7 (RFOUT)
unnamed: C46.1, U11.4 (RF_OUT)
unnamed: C46.2, U9.2 (RFIN)
unnamed: C48.1, P1.1, U11.3 (RF_IN)
unnamed: C49.1, C50.1, FB6.2, L2.2, R22.2
unnamed: C44.1, C45.1, C179.1, C180.1, FB5.2, L1.2, U9.1 (VCC)
unnamed: L2.1, U11.6 (VCC)
unnamed: R22.1, U11.1 (V_ENABLE)
RF_OUT: C42.2

Notes on the sheet:
Gain: 26 dB IP1dB: -16 dBm
Gain: 11 dB NF: 5.5 dB IP1dB: -3 dBm
55 mA
15 mA
Gain: 13 dB NF: 1.0 dB IP1dB: -4 dBm
