Radar-Uniwa/5-6GHz-FMCW-Radar/Hardware/tx.kicad_sch

## KiCad design Hardware/tx.kicad_sch (2026-07-16)

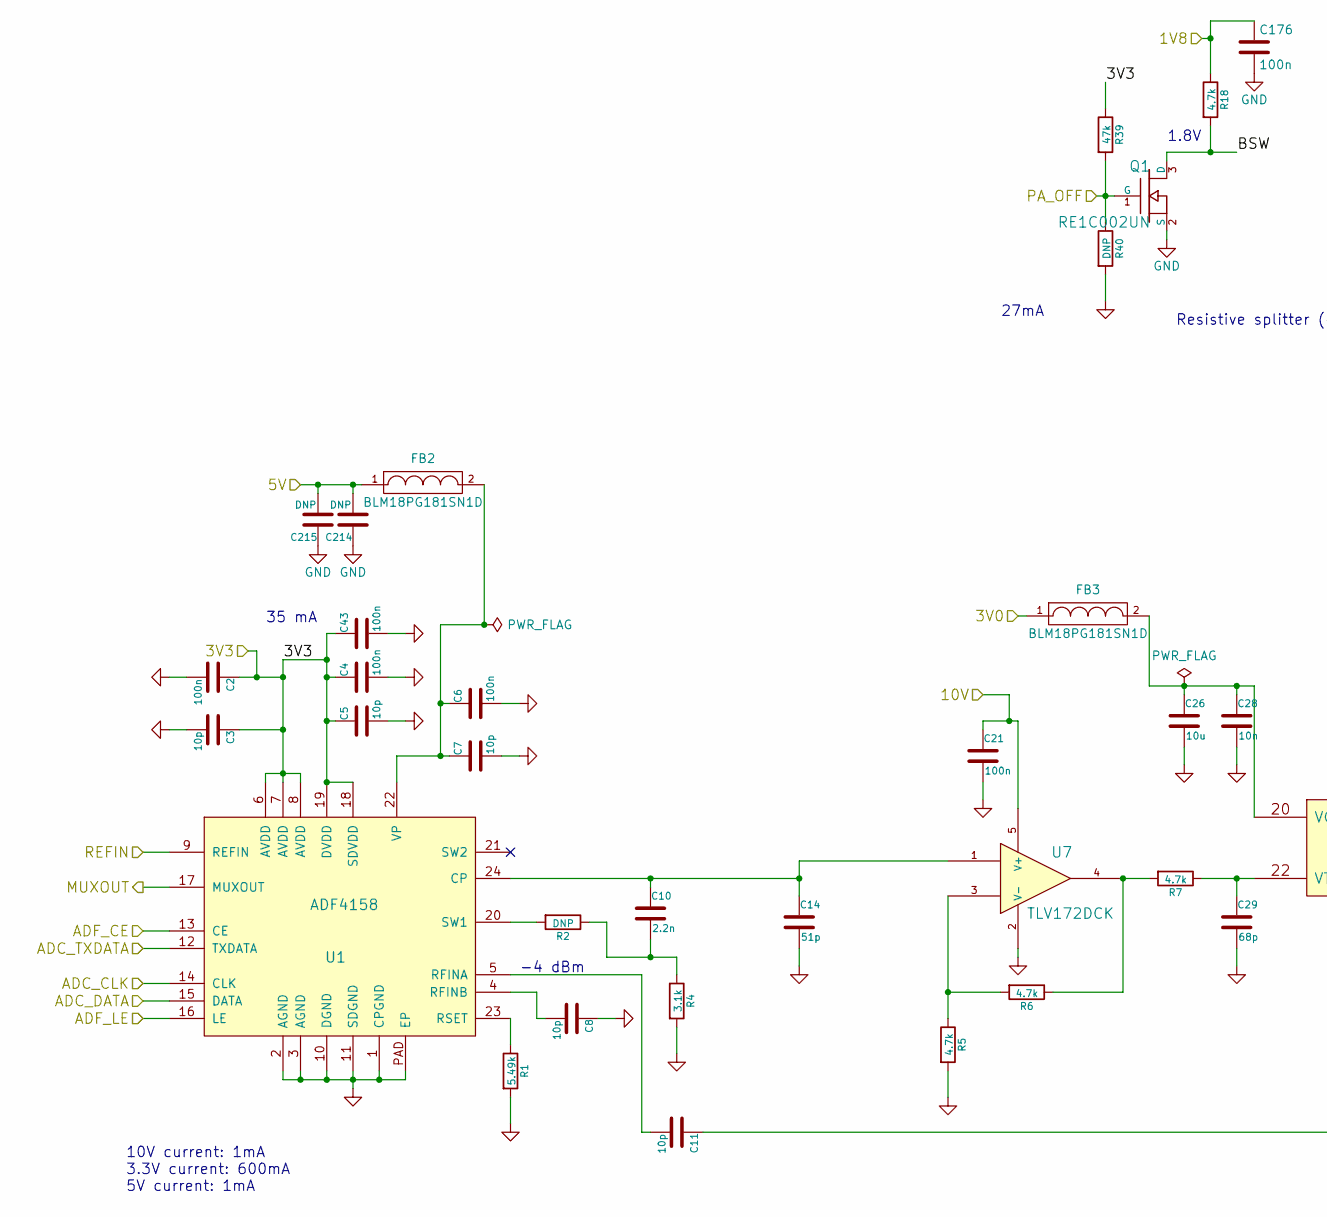
[picture p9: schematic tx.kicad_sch, part in row 1, column 1]

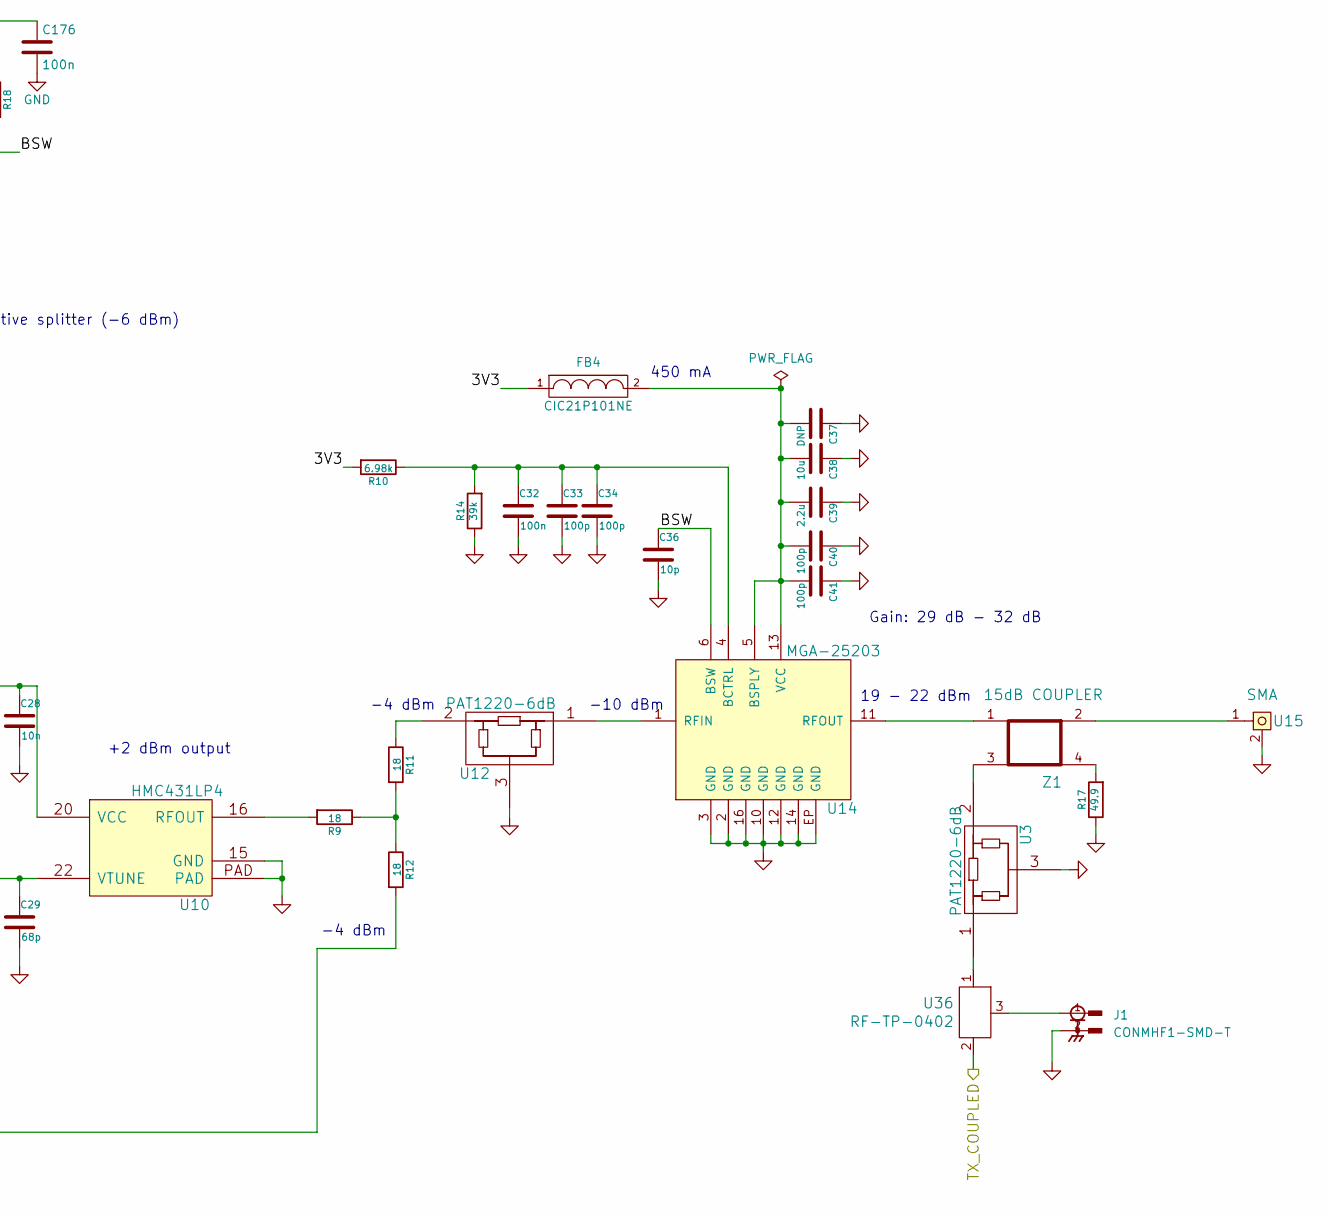
[picture p10: schematic tx.kicad_sch, part in row 1, column 2]

Parts:
C2, C4, C6, C21, C32, C43, C176: 100n; C_0402b
C3, C5, C7, C8, C11, C36: 10p; C_0402b
C10: 2.2n; C_0402b
C14: 51p; C_0402b
C26, C38: 10u; C_0805b
C28: 10n; C_0402b
C29: 68p; C_0402b
C33, C34, C40, C41: 100p; C_0402b
C37: DNP; C_0603b
C39: 2.2u; C_0603b
C214, C215: DNP; C_0805b
FB2, FB3: BLM18PG181SN1D; C_0603b
FB4: CIC21P101NE; C_0805b
J1: CONMHF1-SMD-T; TE_CONMHF1-SMD-T; PARTREV 09/22
Q1: RE1C002UN; SOT-416
R1: 5.49k; R_0402b
R2, R40: DNP; R_0402b
R4: 3.1k; R_0402b
R5, R6, R7, R18: 4.7k; R_0402b
R9, R11, R12: 18; R_0402b
R10: 6.98k; R_0402b
R14: 39k; R_0402b
R17: 49.9; R_0402b
R39: 47k; R_0402b
U1: ADF4158; VFQFN-24
U3, U12: PAT1220-6dB; PAT1220
U7: TLV172DCK; SOT-353_SC-70-5
U10: HMC431LP4; VQFN-24
U14: MGA-25203
U15: SMA; CONSMA003.062
U36: RF-TP-0402
Z1: 15dB COUPLER; coupler

Connections:
1V8: C176.1, R18.1
3V0: FB3.1
3V3: C2.1, C3.1, C4.1, C5.1, C43.1, FB4.1, R10.2, R39.1, U1.6 (AVDD), U1.7 (AVDD), U1.8 (AVDD), U1.18 (SDVDD), U1.19 (DVDD)
5V: C214.2, C215.2, FB2.1
10V: C21.1, U7.5 (V+)
ADC_CLK: U1.14 (CLK)
ADC_DATA: U1.15 (DATA)
ADC_TXDATA: U1.12 (TXDATA)
ADF_CE: U1.13 (CE)
ADF_LE: U1.16 (LE)
BSW: C36.1, Q1.3 (D), R18.2, U14.6 (BSW)
GND: C2.2, C3.2, C4.2, C5.2, C6.2, C7.2, C8.1, C14.2, C21.2, C26.2, C28.2, C29.2, C32.2, C33.2, C34.2, C36.2, C37.1, C38.1, C39.1, C40.1, C41.1, C43.2, C176.2, C214.1, C215.1, J1.2, J1.3, J1.4, Q1.2 (S), R1.2, R4.2, R5.2, R14.1, R17.1, R40.2, U1.1 (CPGND), U1.2 (AGND), U1.3 (AGND), U1.10 (DGND), U1.11 (SDGND), U1.PAD (EP), U3.3, U7.2 (V-), U10.15 (GND), U10.PAD, U12.3, U14.2 (GND), U14.3 (GND), U14.10 (GND), U14.12 (GND), U14.14 (GND), U14.16 (GND), U14.EP (GND), U15.2
MUXOUT: U1.17 (MUXOUT)
unnamed: C6.1, C7.1, FB2.2, U1.22 (VP)
unnamed: C8.2, U1.4 (RFINB)
unnamed: C10.1, C14.1, U1.24 (CP), U7.1
unnamed: C10.2, R2.1, R4.1
unnamed: C11.1, R12.2
unnamed: C11.2, U1.5 (RFINA)
unnamed: C26.1, C28.1, FB3.2, U10.20 (VCC)
unnamed: C29.1, R7.1, U10.22 (VTUNE)
unnamed: C32.1, C33.1, C34.1, R10.1, R14.2, U14.4 (BCTRL)
unnamed: C37.2, C38.2, C39.2, C40.2, C41.2, FB4.2, U14.5 (BSPLY), U14.13 (VCC)
unnamed: J1.1, U36.3
unnamed: R1.1, U1.23 (RSET)
unnamed: R2.2, U1.20 (SW1)
unnamed: R5.1, R6.2, U7.3
unnamed: R6.1, R7.2, U7.4
unnamed: R9.2, U10.16 (RFOUT)
unnamed: R11.1, U12.2
unnamed: R9.1, R11.2, R12.1
unnamed: R17.2, Z1.4
unnamed: U3.1, U36.1
unnamed: U3.2, Z1.3
unnamed: U12.1, U14.1 (RFIN)
unnamed: U14.11 (RFOUT), Z1.1
unnamed: U15.1, Z1.2
PA_OFF: Q1.1 (G), R39.2, R40.1
REFIN: U1.9 (REFIN)
TX_COUPLED: U36.2

Notes on the sheet:
35 mA
+2 dBm output
1.8V
-4 dBm
Gain: 29 dB - 32 dB
27mA
-10 dBm
450 mA
Resistive splitter (-6 dBm)
19 - 22 dBm
10V current: 1mA 3.3V current: 600mA 5V current: 1mA
