Radar-Uniwa/5-6GHz-FMCW-Radar/Hardware/usb.kicad_sch

## KiCad design Hardware/usb.kicad_sch (2026-07-16)

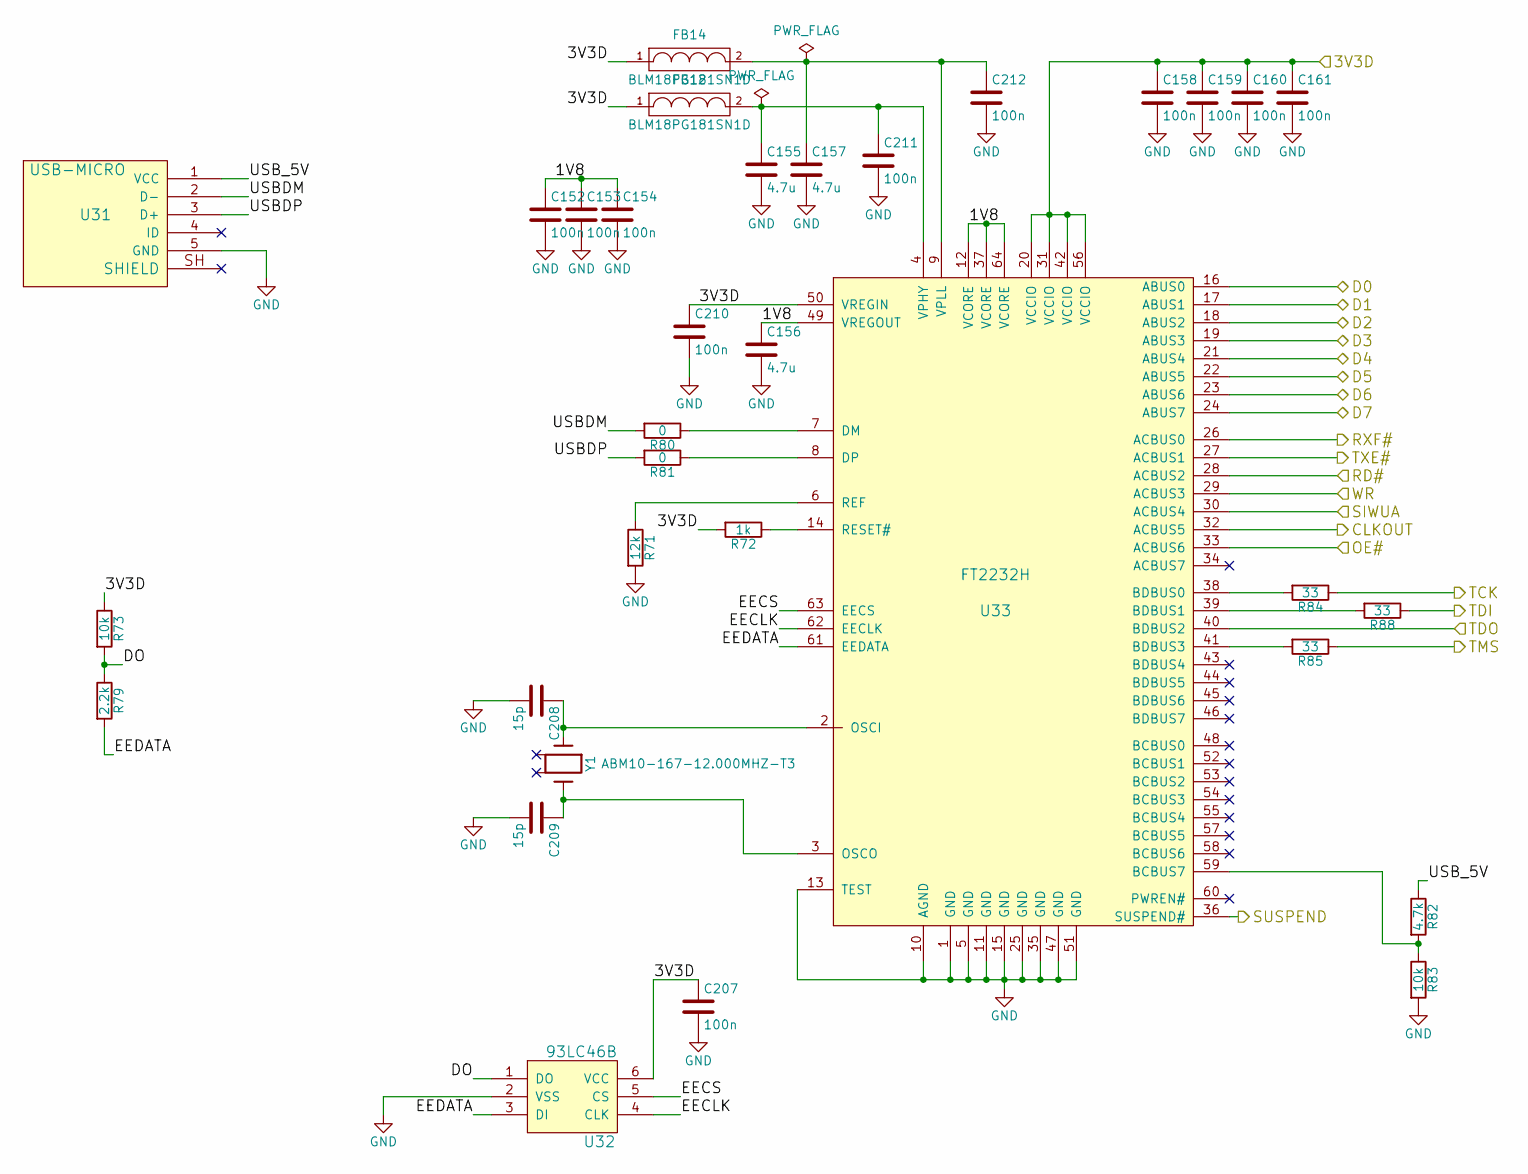
[picture p11: schematic usb.kicad_sch]

Parts:
C152, C153, C154, C158, C159, C160, C161, C207, C210, C211, C212: 100n; C_0402b
C155, C156, C157: 4.7u; C_0603b
C208, C209: 15p; C_0402b
FB12, FB14: BLM18PG181SN1D; C_0603b
R71: 12k; R_0402b
R72: 1k; R_0402b
R73, R83: 10k; R_0402b
R79: 2.2k; R_0402b
R80, R81: 0; R_0402b
R82: 4.7k; R_0402b
R84, R85, R88: 33; R_0402b
U31: USB-MICRO; USB_MICRO
U32: 93LC46B; SOT-23-6
U33: FT2232H; LQFP-64_10x10mm_Pitch0.5mm
Y1: ABM10-167-12.000MHZ-T3; ABM10

Connections:
1V8: C152.1, C153.1, C154.1, C156.1, U33.12 (VCORE), U33.37 (VCORE), U33.49 (VREGOUT), U33.64 (VCORE)
3V3D: C158.1, C159.1, C160.1, C161.1, C207.1, C210.1, FB12.1, FB14.1, R72.2, R73.1, U32.6 (VCC), U33.20 (VCCIO), U33.31 (VCCIO), U33.42 (VCCIO), U33.50 (VREGIN), U33.56 (VCCIO)
CLKOUT: U33.32 (ACBUS5)
D0: U33.16 (ABUS0)
D1: U33.17 (ABUS1)
D2: U33.18 (ABUS2)
D3: U33.19 (ABUS3)
D4: U33.21 (ABUS4)
D5: U33.22 (ABUS5)
D6: U33.23 (ABUS6)
D7: U33.24 (ABUS7)
DO: R73.2, R79.1, U32.1 (DO)
EECLK: U32.4 (CLK), U33.62 (EECLK)
EECS: U32.5 (CS), U33.63 (EECS)
EEDATA: R79.2, U32.3 (DI), U33.61 (EEDATA)
GND: C152.2, C153.2, C154.2, C155.2, C156.2, C157.2, C158.2, C159.2, C160.2, C161.2, C207.2, C208.2, C209.2, C210.2, C211.2, C212.2, R71.2, R83.2, U31.5 (GND), U32.2 (VSS), U33.1 (GND), U33.5 (GND), U33.10 (AGND), U33.11 (GND), U33.13 (TEST), U33.15 (GND), U33.25 (GND), U33.35 (GND), U33.47 (GND), U33.51 (GND)
unnamed: C155.1, C211.1, FB12.2, U33.4 (VPHY)
unnamed: C157.1, C212.1, FB14.2, U33.9 (VPLL)
unnamed: C208.1, U33.2 (OSCI), Y1.1
unnamed: C209.1, U33.3 (OSCO), Y1.3
unnamed: R71.1, U33.6 (REF)
unnamed: R72.1, U33.14 (RESET#)
unnamed: R80.1, U33.7 (DM)
unnamed: R81.1, U33.8 (DP)
unnamed: R82.2, R83.1, U33.59 (BCBUS7)
unnamed: R84.2, U33.38 (BDBUS0)
unnamed: R85.2, U33.41 (BDBUS3)
unnamed: R88.2, U33.39 (BDBUS1)
OE#: U33.33 (ACBUS6)
RD#: U33.28 (ACBUS2)
RXF#: U33.26 (ACBUS0)
SIWUA: U33.30 (ACBUS4)
SUSPEND: U33.36 (SUSPEND#)
TCK: R84.1
TDI: R88.1
TDO: U33.40 (BDBUS2)
TMS: R85.1
TXE#: U33.27 (ACBUS1)
USBDM: R80.2, U31.2 (D-)
USBDP: R81.2, U31.3 (D+)
USB_5V: R82.1, U31.1 (VCC)
WR: U33.29 (ACBUS3)
